hexeguitar/FV-1_devRemote/(commit log)

2021-01-25 renamed server.h to avoid conflict with core lib
    [fv1_server.cpp, fv1_server.h, main.cpp]
2021-03-09 unix line ending fix
    [fv1.cpp, fv1.h]
